Berselli-DiBlasi-Projects/Progettazione-Elettronica-Digitale/Relazione Progettazione Elettronica/Schema Elettrico/WhatsApp Image 2019-05-29 at 16.55.06.jpeg

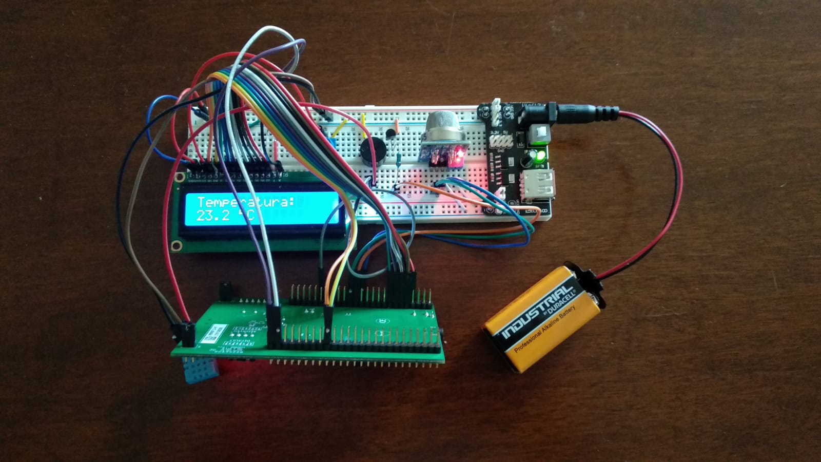
Relazione Progettazione Elettronica/Schema Elettrico/WhatsApp Image 2019-05-29 at 16.55.06.jpeg
