Berselli-DiBlasi-Projects/Progettazione-Elettronica-Digitale/README.md

# Progettazione-Elettronica-Digitale
Progetto di un sensore di rilevamento fuga di gas naturale, temperatura ed umidità basato su STM32F4.
