Berselli-DiBlasi-Projects/Progettazione-Elettronica-Digitale/Relazione Progettazione Elettronica/Schema Elettrico/Schematic_led-aggiuntivo_Sheet-1_20190530175318.png

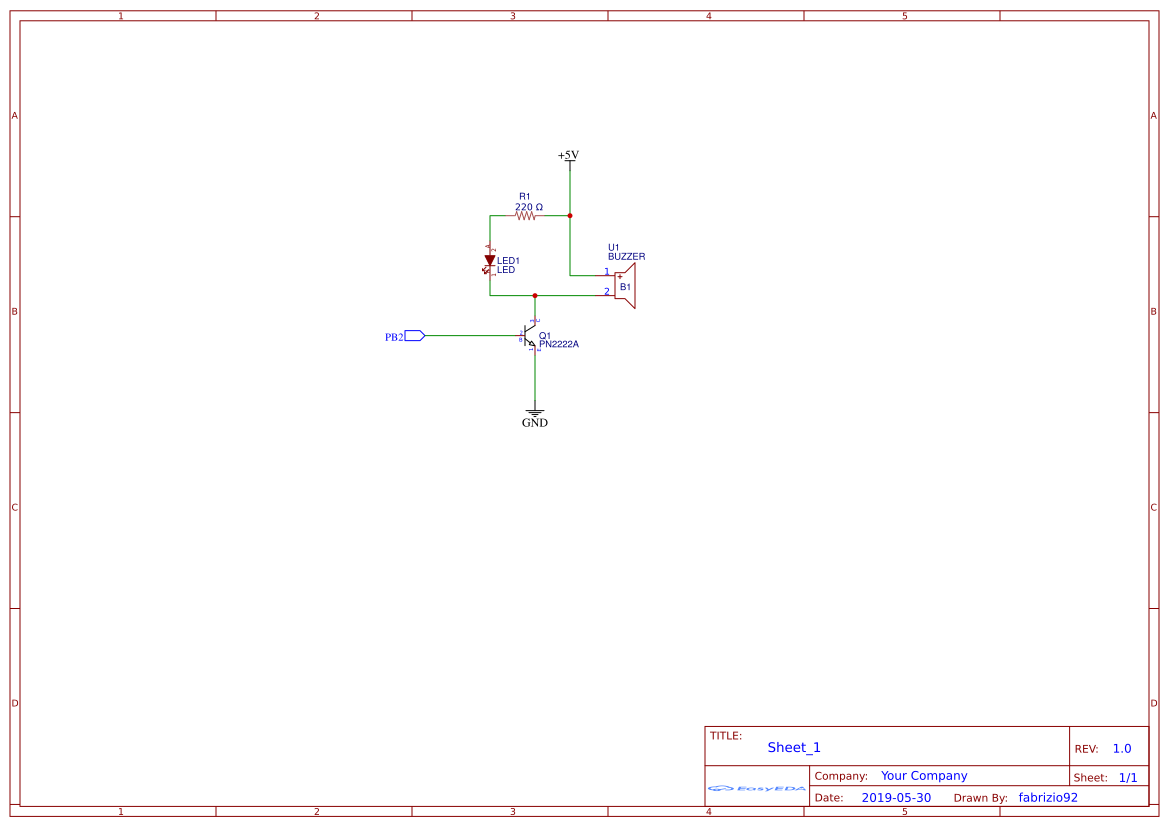
Relazione Progettazione Elettronica/Schema Elettrico/Schematic_led-aggiuntivo_Sheet-1_20190530175318.png
