Berselli-DiBlasi-Projects/Progettazione-Elettronica-Digitale/Relazione Progettazione Elettronica/Schema Elettrico/Schematic_schema-eletrico-PED_Sheet-1_20190530153507.pdf

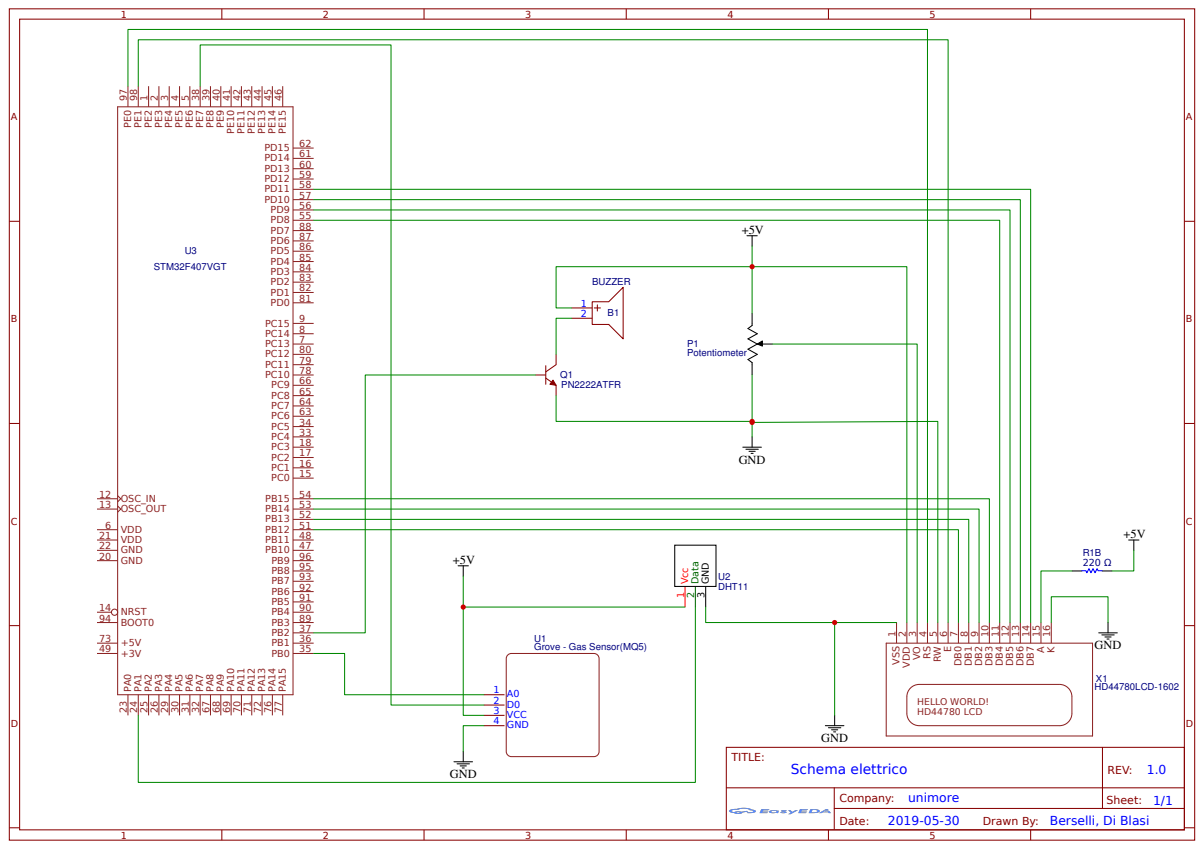
[picture p18: page 1]
TITLE:; Schema elettrico; REV: 1.0; Date:; Sheet: 1/1; Company: unimore; VCC; GND; BUZZER; HD44780LCD-1602; HELLO WORLD! HD44780 LCD; PN2222ATFR; STM32F407VGT; GND 22; BOOT0 94; NRST 14; OSC_IN 12 OSC_OUT 13; GND 20; VDD; VDD 21; Potentiometer; DHT11; Vcc 1; Data 2 GND 3

K 16 A 15 DB7 14 DB6 13 DB5 12 DB4 11 DB3 10 DB2 9 DB1 8 DB0 7 E 6 RW 5 RS 4 VO 3 VDD 2 VSS 1

Grove - Gas Sensor(MQ5)

Drawn By: Berselli, Di Blasi
