Berselli-DiBlasi-Projects/Progettazione-Elettronica-Digitale/Src/main.c

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

/* Includes ------------------------------------------------------------------*/
#include "main.h"

/* USER CODE BEGIN Includes */
#include "LCD_Display.h"
#include "DHT11.h"
/* USER CODE END Includes */

ADC_HandleTypeDef hadc1;

IWDG_HandleTypeDef hiwdg;

/* USER CODE BEGIN PV */
struct dht11_measurements dht11ms;
/* USER CODE END PV */

void SystemClock_Config(void);
static void MX_GPIO_Init(void);
static void MX_ADC1_Init(void);
static void MX_IWDG_Init(void);
/**
  * @brief  The application entry point.
  * @retval int
  */
int main(void)
{
  /* MCU Configuration--------------------------------------------------------*/

  /* Reset of all peripherals, Initializes the Flash interface and the Systick. */
  HAL_Init();

  /* Configure the system clock */
  SystemClock_Config();

  /* Initialize all configured peripherals */
  MX_GPIO_Init();
  MX_ADC1_Init();
  /* USER CODE BEGIN 2 */
	
	//int val;
	LCD1602_setGPIOPorts(RS_GPIO_Port, RS_Pin, E_Pin, D0_GPIO_Port, D0_Pin, D1_Pin, D2_Pin, D3_Pin, D4_GPIO_Port, D4_Pin, D5_Pin, D6_Pin, D7_Pin);
	LCD1602_Begin8BIT();
	DWT_Delay_Init();
	dht11_measurements_init(&dht11ms);
	
  /* USER CODE END 2 */

  /* Infinite loop */
  /* USER CODE BEGIN WHILE */
	
	HAL_GPIO_EXTI_IRQHandler(GAS_FLAG_Pin); 
	MX_IWDG_Init();	
  while (1)
  {
		HAL_IWDG_Refresh(&hiwdg);
		hiwdg.Instance->PR = hiwdg.Init.Prescaler;
		hiwdg.Instance->RLR = hiwdg.Init.Reload;
		//IWDG->KR=0xAA;
		dht11_measurements_addvalue(&dht11ms);
		HAL_GPIO_WritePin(GPIOB,BUZZ_Pin,GPIO_PIN_RESET);
		print_dht11_measurements(&dht11ms);
    /* USER CODE END WHILE */

    /* USER CODE BEGIN 3 */
  }
  /* USER CODE END 3 */
}

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
