Berselli-DiBlasi-Projects/Progettazione-Elettronica-Digitale/Inc/main.h

#define BUZZ_Pin GPIO_PIN_2
#define BUZZ_GPIO_Port GPIOB
#define GAS_FLAG_Pin GPIO_PIN_7
#define GAS_FLAG_GPIO_Port GPIOE
#define GAS_FLAG_EXTI_IRQn EXTI9_5_IRQn
#define D0_Pin GPIO_PIN_12
#define D0_GPIO_Port GPIOB
#define D1_Pin GPIO_PIN_13
#define D1_GPIO_Port GPIOB
#define D2_Pin GPIO_PIN_14
#define D2_GPIO_Port GPIOB
#define D3_Pin GPIO_PIN_15
#define D3_GPIO_Port GPIOB
#define D4_Pin GPIO_PIN_8
#define D4_GPIO_Port GPIOD
#define D5_Pin GPIO_PIN_9
#define D5_GPIO_Port GPIOD
#define D6_Pin GPIO_PIN_10
#define D6_GPIO_Port GPIOD
#define D7_Pin GPIO_PIN_11
#define D7_GPIO_Port GPIOD
#define RS_Pin GPIO_PIN_0
#define RS_GPIO_Port GPIOE
#define E_Pin GPIO_PIN_1
#define E_GPIO_Port GPIOE
